mlab-modules/I2CADC01/README.md

# I2CADC01A  - 24-bit ADC converter with I2C interface

The ADC includes a temperature sensor that can be used to compensate cold-junction temperature. Therefore, this module is suitable for use of temperature measurement by thermocouples.

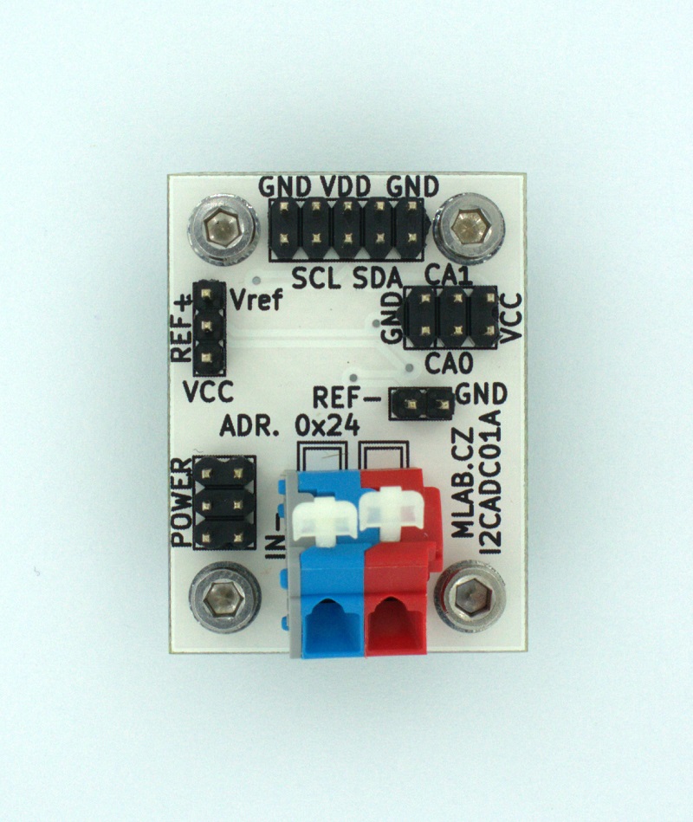
[picture p1: doc/img/I2CADC01A_small.jpg]
LeadImg
