mlab-modules/I2CADC01/doc/gen/README.md

# PCB

Board size: 29.97x40.13 mm (1.18x1.58 inches)

- This is the size of the rectangle that contains the board
- Thickness: 1.6 mm (63 mils)
- Material: FR4
- Finish: HAL
- Layers: 2
- Copper thickness: 35 µm

Solder mask: TOP / BOTTOM

- Color: Green

Silk screen: TOP / BOTTOM

- Color: White

# Important sizes

Clearance: 0.2 mm (8 mils)

Track width: 0.25 mm (10 mils)

- By design rules: 0.25 mm (10 mils)

Drill: 0.75 mm (30 mils)

- Vias: 0.75 mm (30 mils) [Design: 0.6 mm (24 mils)]
- Pads: 1.0 mm (39 mils)
- The above values are real drill sizes, they add 0.1 mm (4 mils) to plated holes (PTH)

Via: 0.89/0.64 mm (35/25 mils)

- By design rules: 0.89/0.51 mm (35/20 mils)
- Micro via: yes [0.51/0.13 mm (20/5 mils)]
- Buried/blind via: yes
- Total: 4 (thru: 4 buried/blind: 0 micro: 0)

Outer Annular Ring: 0.07 mm (3 mils)

- By design rules: 0.26 mm (10 mils)

Eurocircuits class: 10A
- Using min drill 0.75 mm for an OAR of 0.07 mm

# General stats

Components count: (SMD/THT)

- Top: 0/13 (THT)
- Bottom: 19/1 (SMD + THT)

Defined tracks:

- 0.3 mm (12 mils)
- 0.4 mm (16 mils)
- 0.5 mm (20 mils)

Used tracks:

- 0.25 mm (10 mils) (17) defined: no
- 0.3 mm (12 mils) (38) defined: yes
- 0.4 mm (16 mils) (24) defined: yes
- 0.5 mm (20 mils) (64) defined: yes

Defined vias:

Used vias:

- 0.89/0.64 mm (35/25 mils) (Count: 4, Aspect: 1.8 A) defined: no

Holes (excluding vias):

- 0.89 mm (35 mils) (27)
- 1.3 mm (51 mils) (4)
- 3.0 mm (118 mils) (4)

Oval holes:

Drill tools (including vias and computing adjusts and rounding):

- 0.75 mm (30 mils) (4)
- 1.0 mm (39 mils) (27)
- 1.4 mm (55 mils) (4)
- 3.1 mm (122 mils) (4)

Solder paste stats:

Using a paste with 87.75 % alloy, that has an specific gravity for the alloy of 7.4 g/cm³
and 1.0 g/cm³ for the flux. This paste has an specific gravity of  4.15 g/cm³.

The stencil thickness is  0.12 mm.

| Side | Pads with paste | Area [mm²] | Paste [g] |
|---|---|---|---|
| Total  | 53 | 63.30 | 0.32 |

Note: this is just an approximation to the theoretical value. Margins of the solder mask and waste aren't computed.
