mlab-modules/I2CADC01/doc/gen/img/I2CADC01-bottom.png

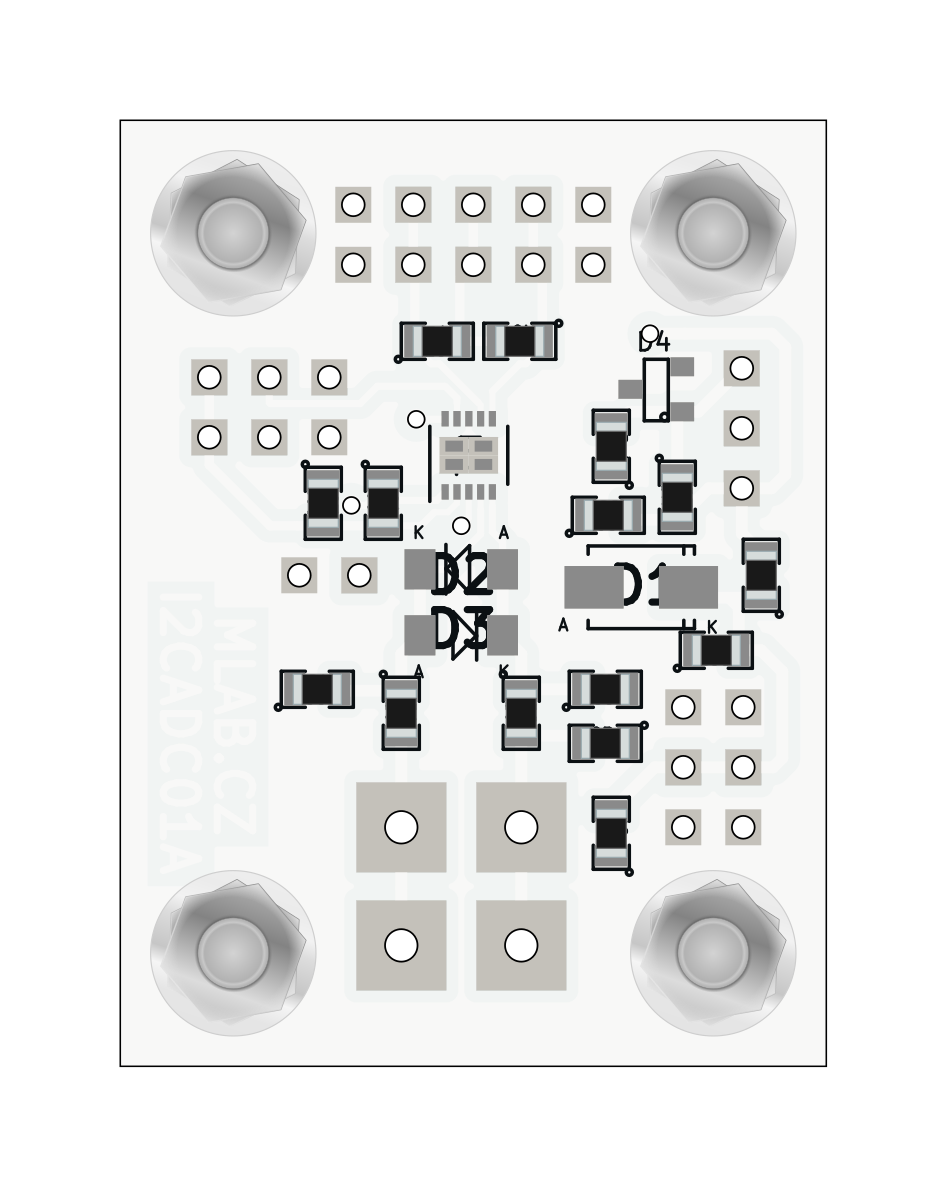
doc/gen/img/I2CADC01-bottom.png
