mlab-modules/I2CADC01/doc/gen/img/I2CADC01-top.png

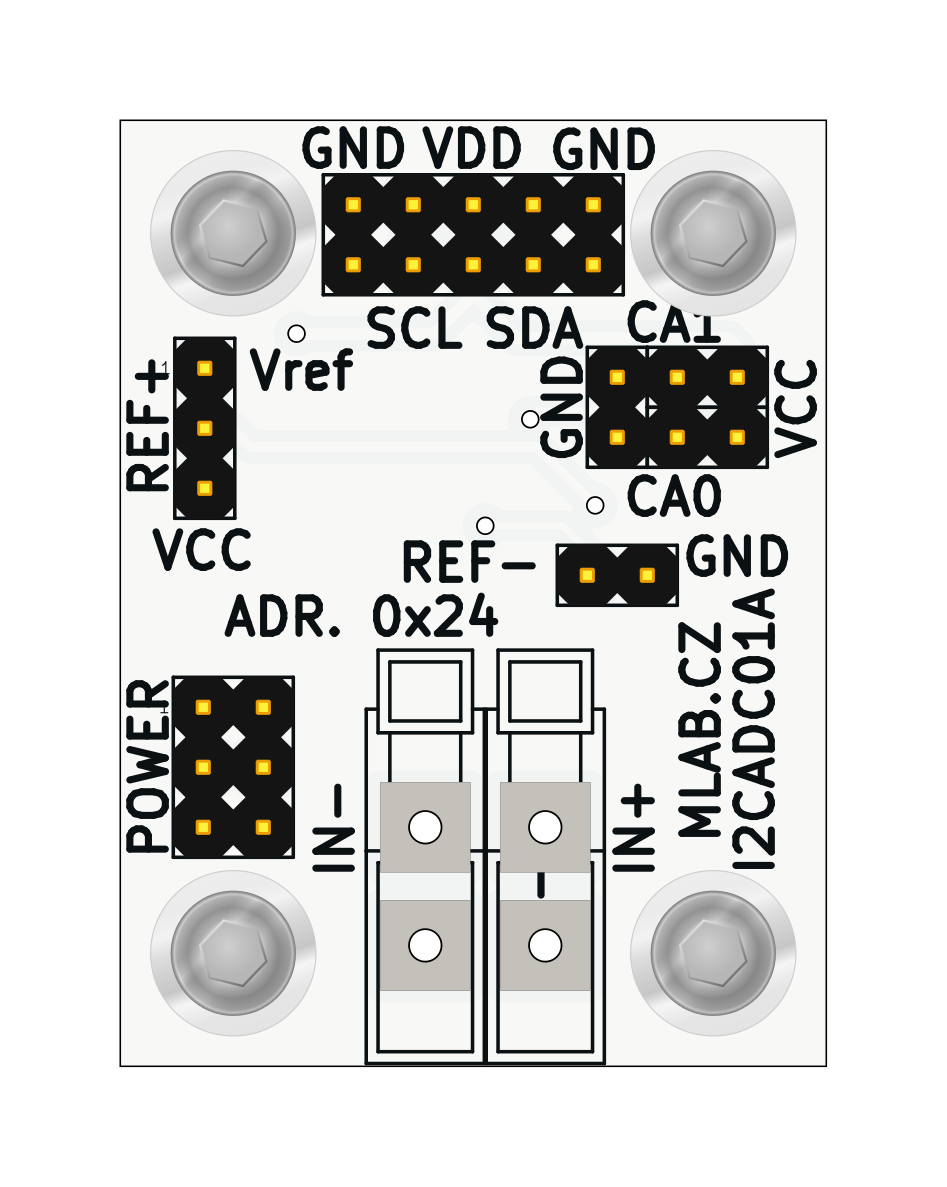
doc/gen/img/I2CADC01-top.png
