mlab-modules/I2CADC01/doc/gen/dxf/I2CADC01-B_Cu.dxf

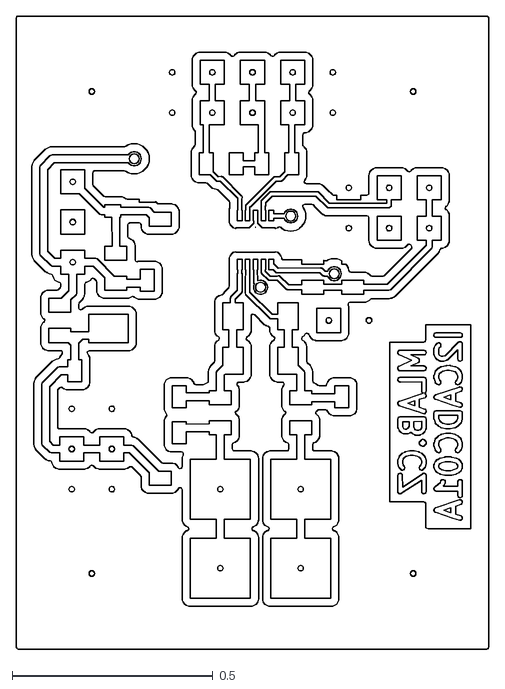
[picture p8: CAD file, 2024-07-16]
doc/gen/dxf/I2CADC01-B_Cu.dxf
1.18 x 1.58
