mlab-modules/I2CADC01/doc/gen/I2CADC01.step

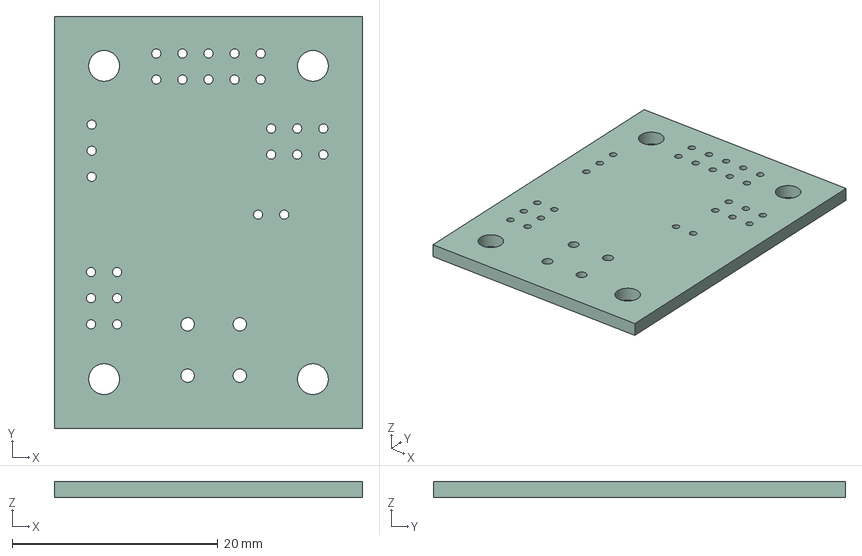
[picture p9: CAD file, 2024-07-16]
doc/gen/I2CADC01.step
30.0 x 40.1 x 1.60 mm
