mlab-modules/I2CADC01/doc/gen/dxf/I2CADC01-B_Courtyard.dxf

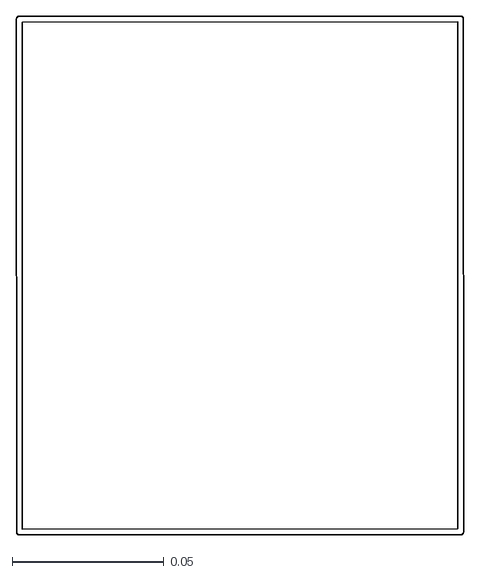
[picture p10: CAD file, 2024-07-16]
doc/gen/dxf/I2CADC01-B_Courtyard.dxf
0.148 x 0.171
