mlab-modules/I2CADC01/doc/gen/dxf/I2CADC01-F_Cu.dxf

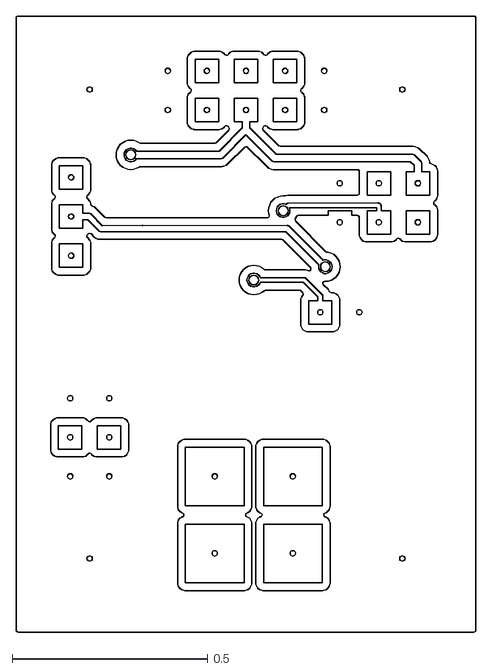
[picture p11: CAD file, 2024-07-16]
doc/gen/dxf/I2CADC01-F_Cu.dxf
1.18 x 1.58
