mlab-modules/I2CADC01/doc/gen/dxf/I2CADC01-B_Fab.dxf

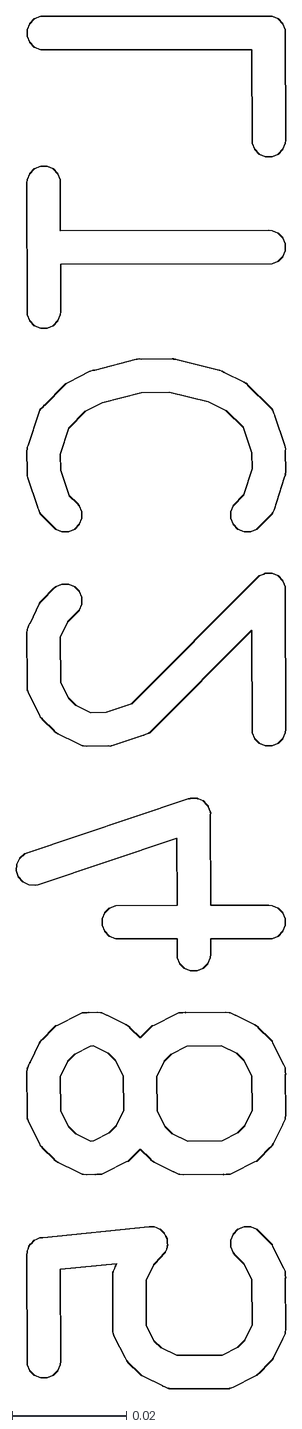
[picture p12: CAD file, 2024-07-16]
doc/gen/dxf/I2CADC01-B_Fab.dxf
0.0471 x 0.24
