mlab-modules/I2CADC01/doc/gen/dxf/I2CADC01-Edge_Cuts.dxf

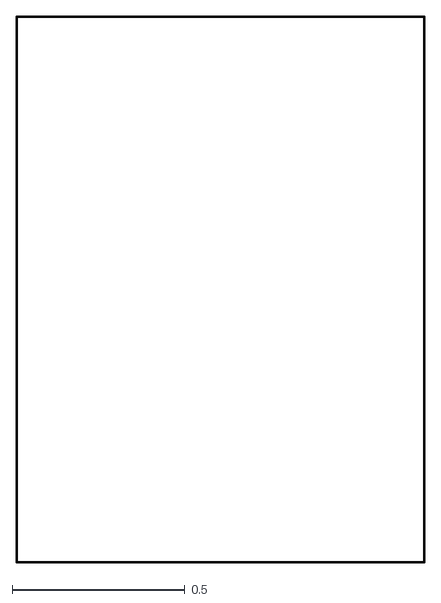
[picture p13: CAD file, 2024-07-16]
doc/gen/dxf/I2CADC01-Edge_Cuts.dxf
1.18 x 1.58
