mlab-modules/I2CADC01/doc/gen/dxf/I2CADC01-User_Comments.dxf

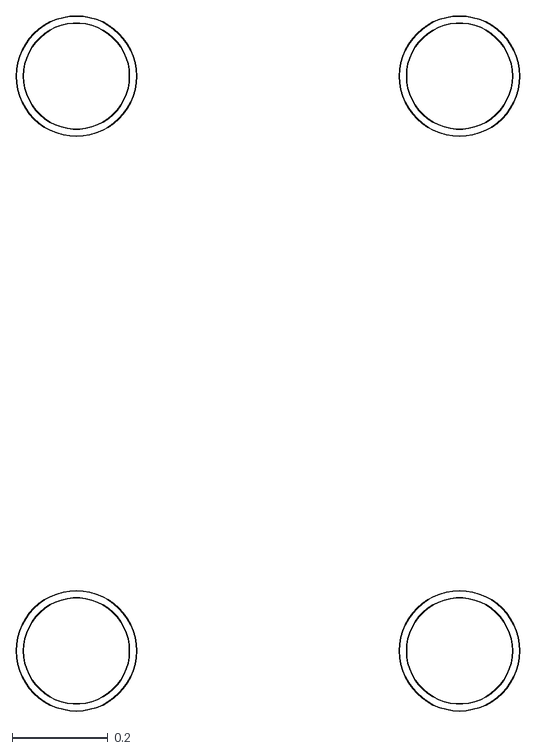
[picture p14: CAD file, 2024-05-31]
doc/gen/dxf/I2CADC01-User_Comments.dxf
1.05 x 1.45
