mlab-modules/I2CADC01/doc/gen/dxf/I2CADC01-B_Adhesive.dxf

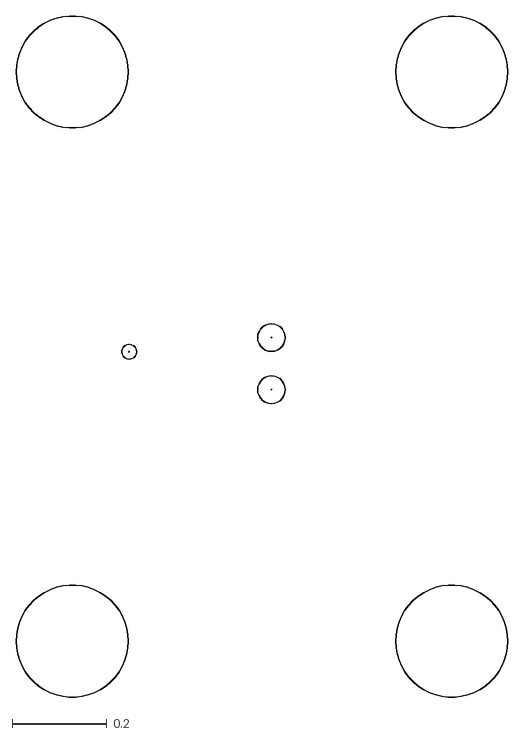
[picture p15: CAD file, 2024-05-31]
doc/gen/dxf/I2CADC01-B_Adhesive.dxf
1.04 x 1.44
