mlab-modules/I2CADC01/doc/gen/dxf/I2CADC01-F_Adhesive.dxf

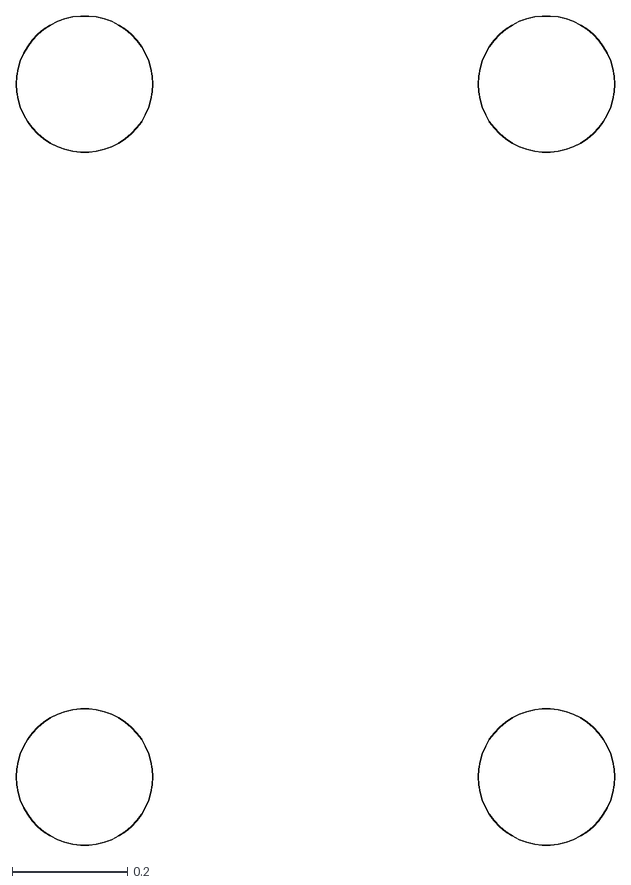
[picture p16: CAD file, 2024-05-31]
doc/gen/dxf/I2CADC01-F_Adhesive.dxf
1.04 x 1.44
