mlab-modules/I2CADC01/(list of files, cad)

Other CAD files:
doc/gen/dxf/I2CADC01-User_Drawings.dxf
doc/gen/dxf/I2CADC01-Margin.dxf
doc/gen/dxf/I2CADC01-F_Courtyard.dxf
doc/gen/dxf/I2CADC01-User_Eco1.dxf
doc/gen/dxf/I2CADC01-F_Fab.dxf
doc/gen/dxf/I2CADC01-User_Eco2.dxf
doc/gen/dxf/I2CADC01-B_Mask.dxf
doc/gen/dxf/I2CADC01-B_Paste.dxf
doc/gen/dxf/I2CADC01-B_Silkscreen.dxf
doc/gen/dxf/I2CADC01-F_Mask.dxf
doc/gen/dxf/I2CADC01-F_Paste.dxf
doc/gen/dxf/I2CADC01-F_Silkscreen.dxf
