mlab-modules/I2CADC01/doc/gen/I2CADC01-schematic.pdf

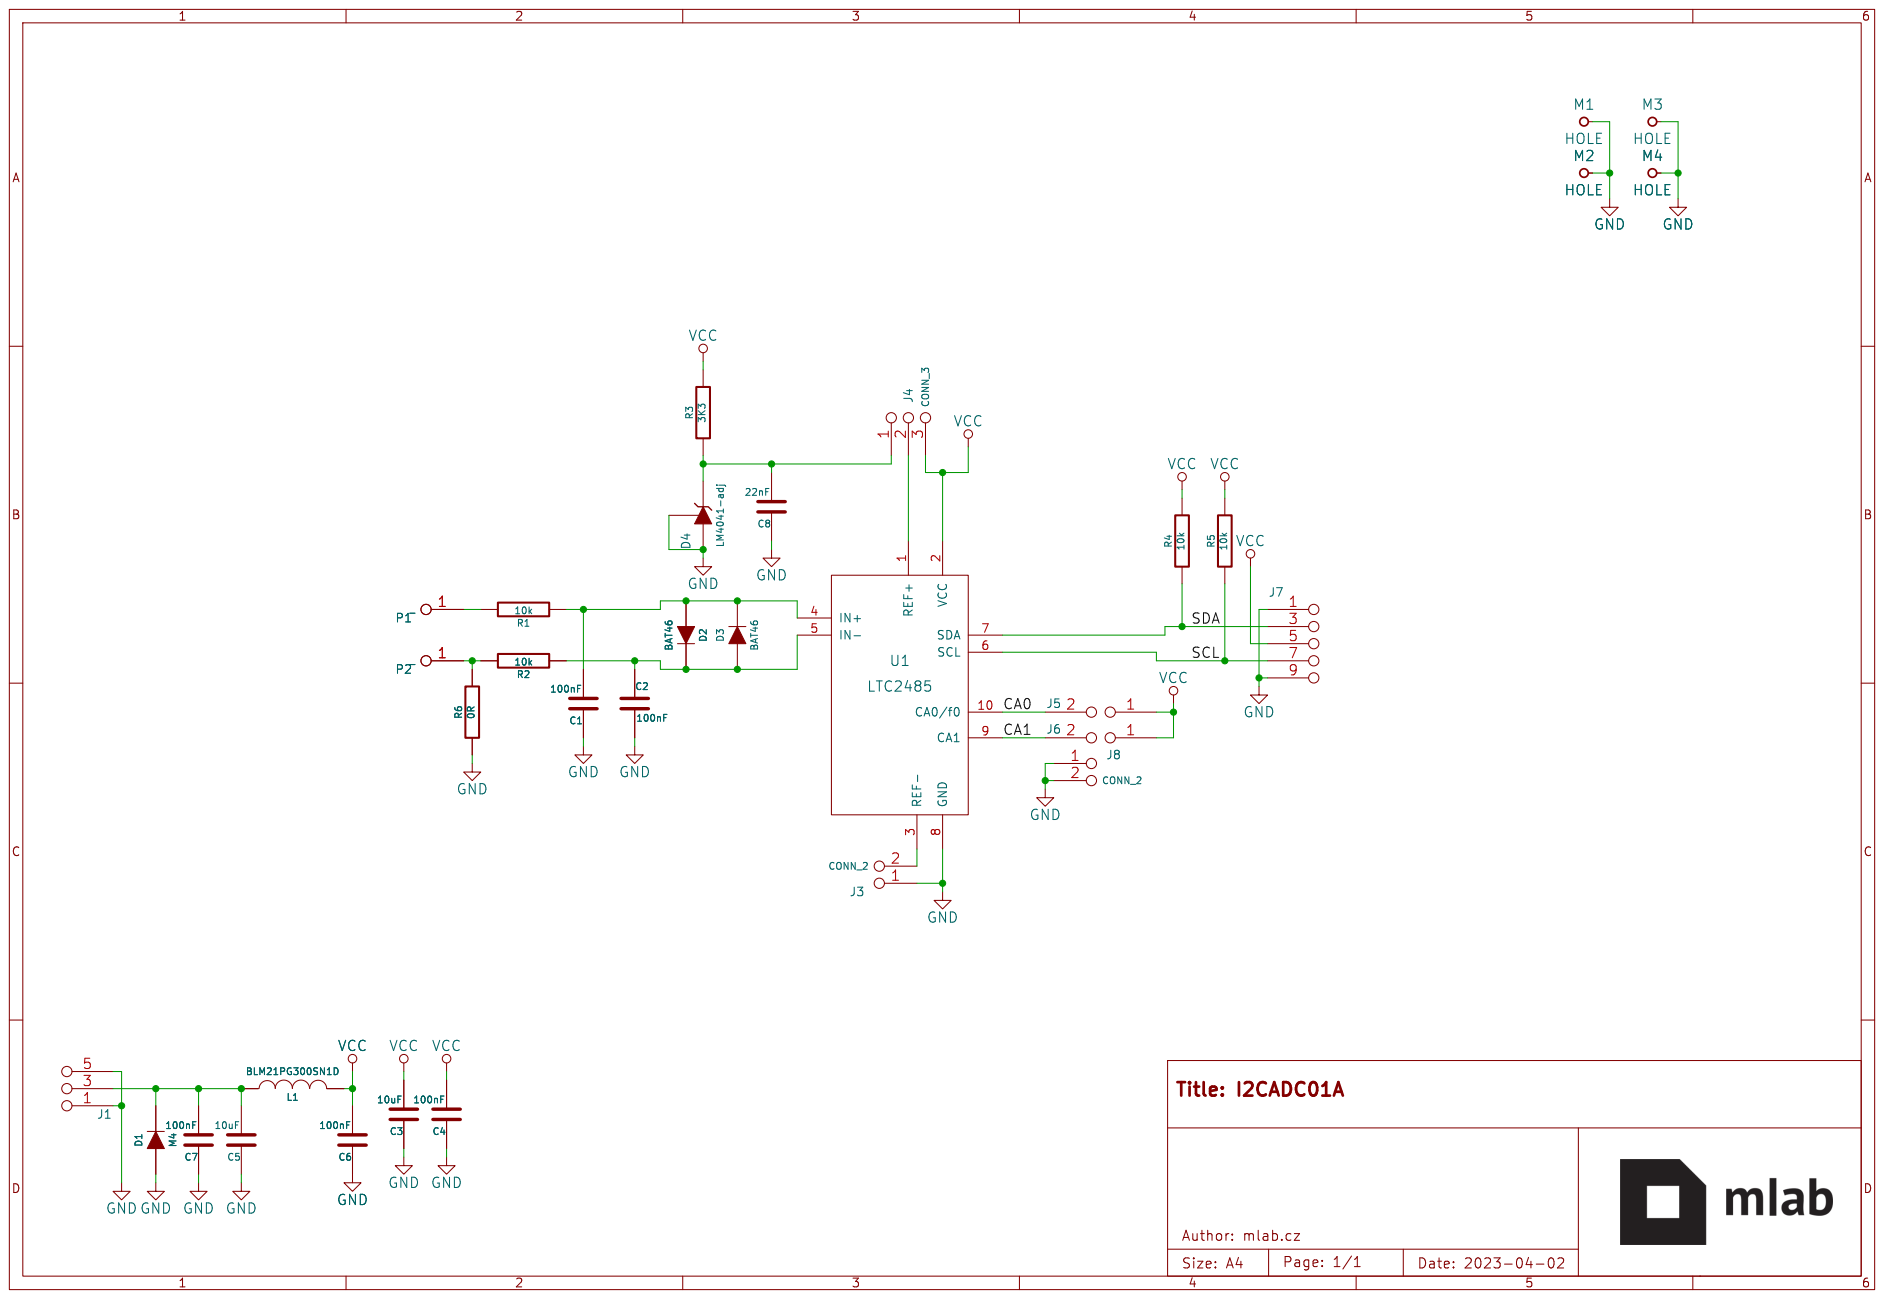
[picture p17: page 1]
