mlab-modules/I2CADC01/hw/cam_profi/assembly/I2CADC01-B_Fab+Edge_Cuts.pdf

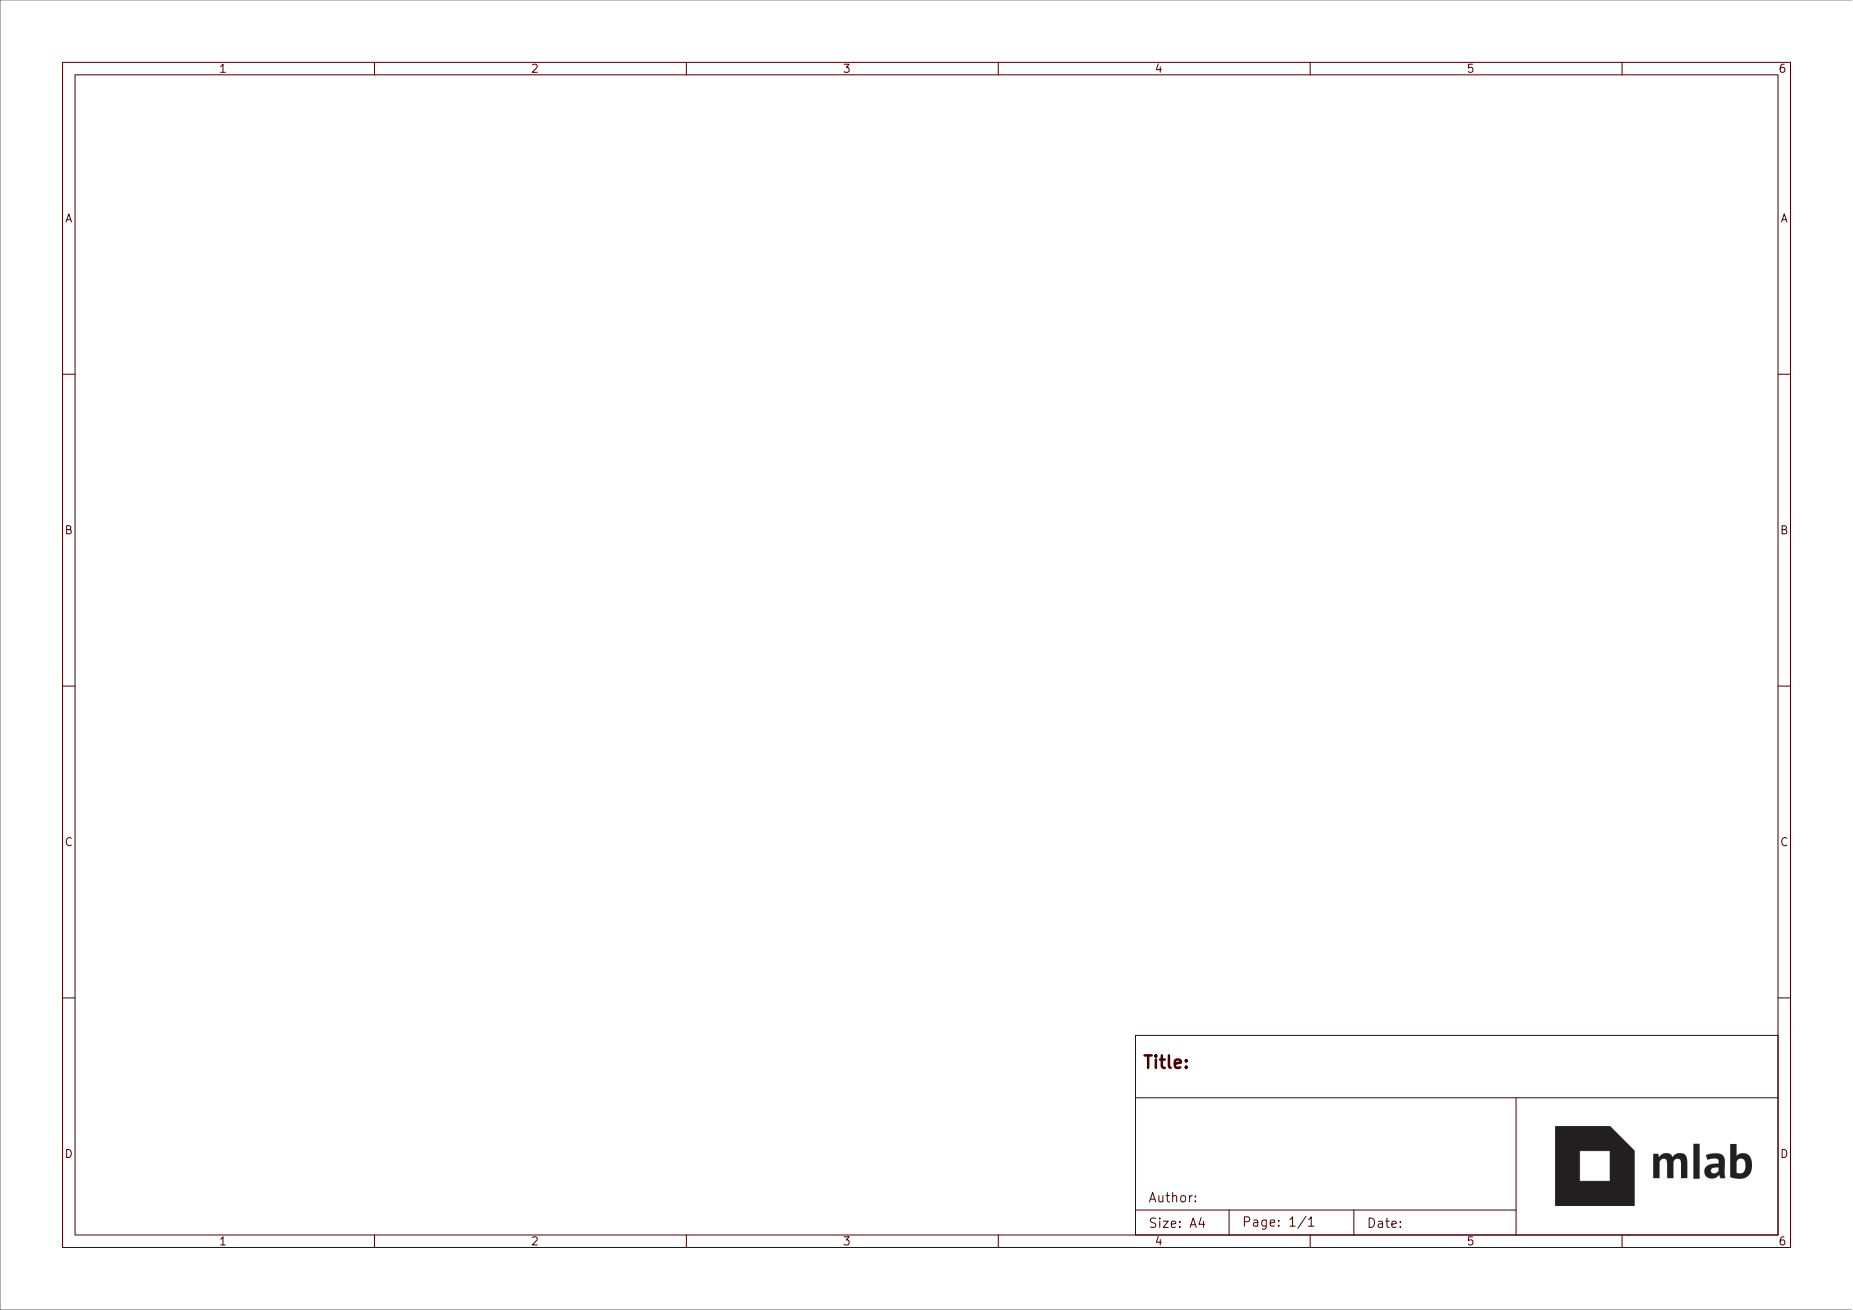
[picture p18: page 1]
