mlab-modules/I2CADC01/hw/sch_pcb/I2CADC01.kicad_pcb

## KiCad design hw/sch_pcb/I2CADC01.kicad_pcb (2023-10-28)

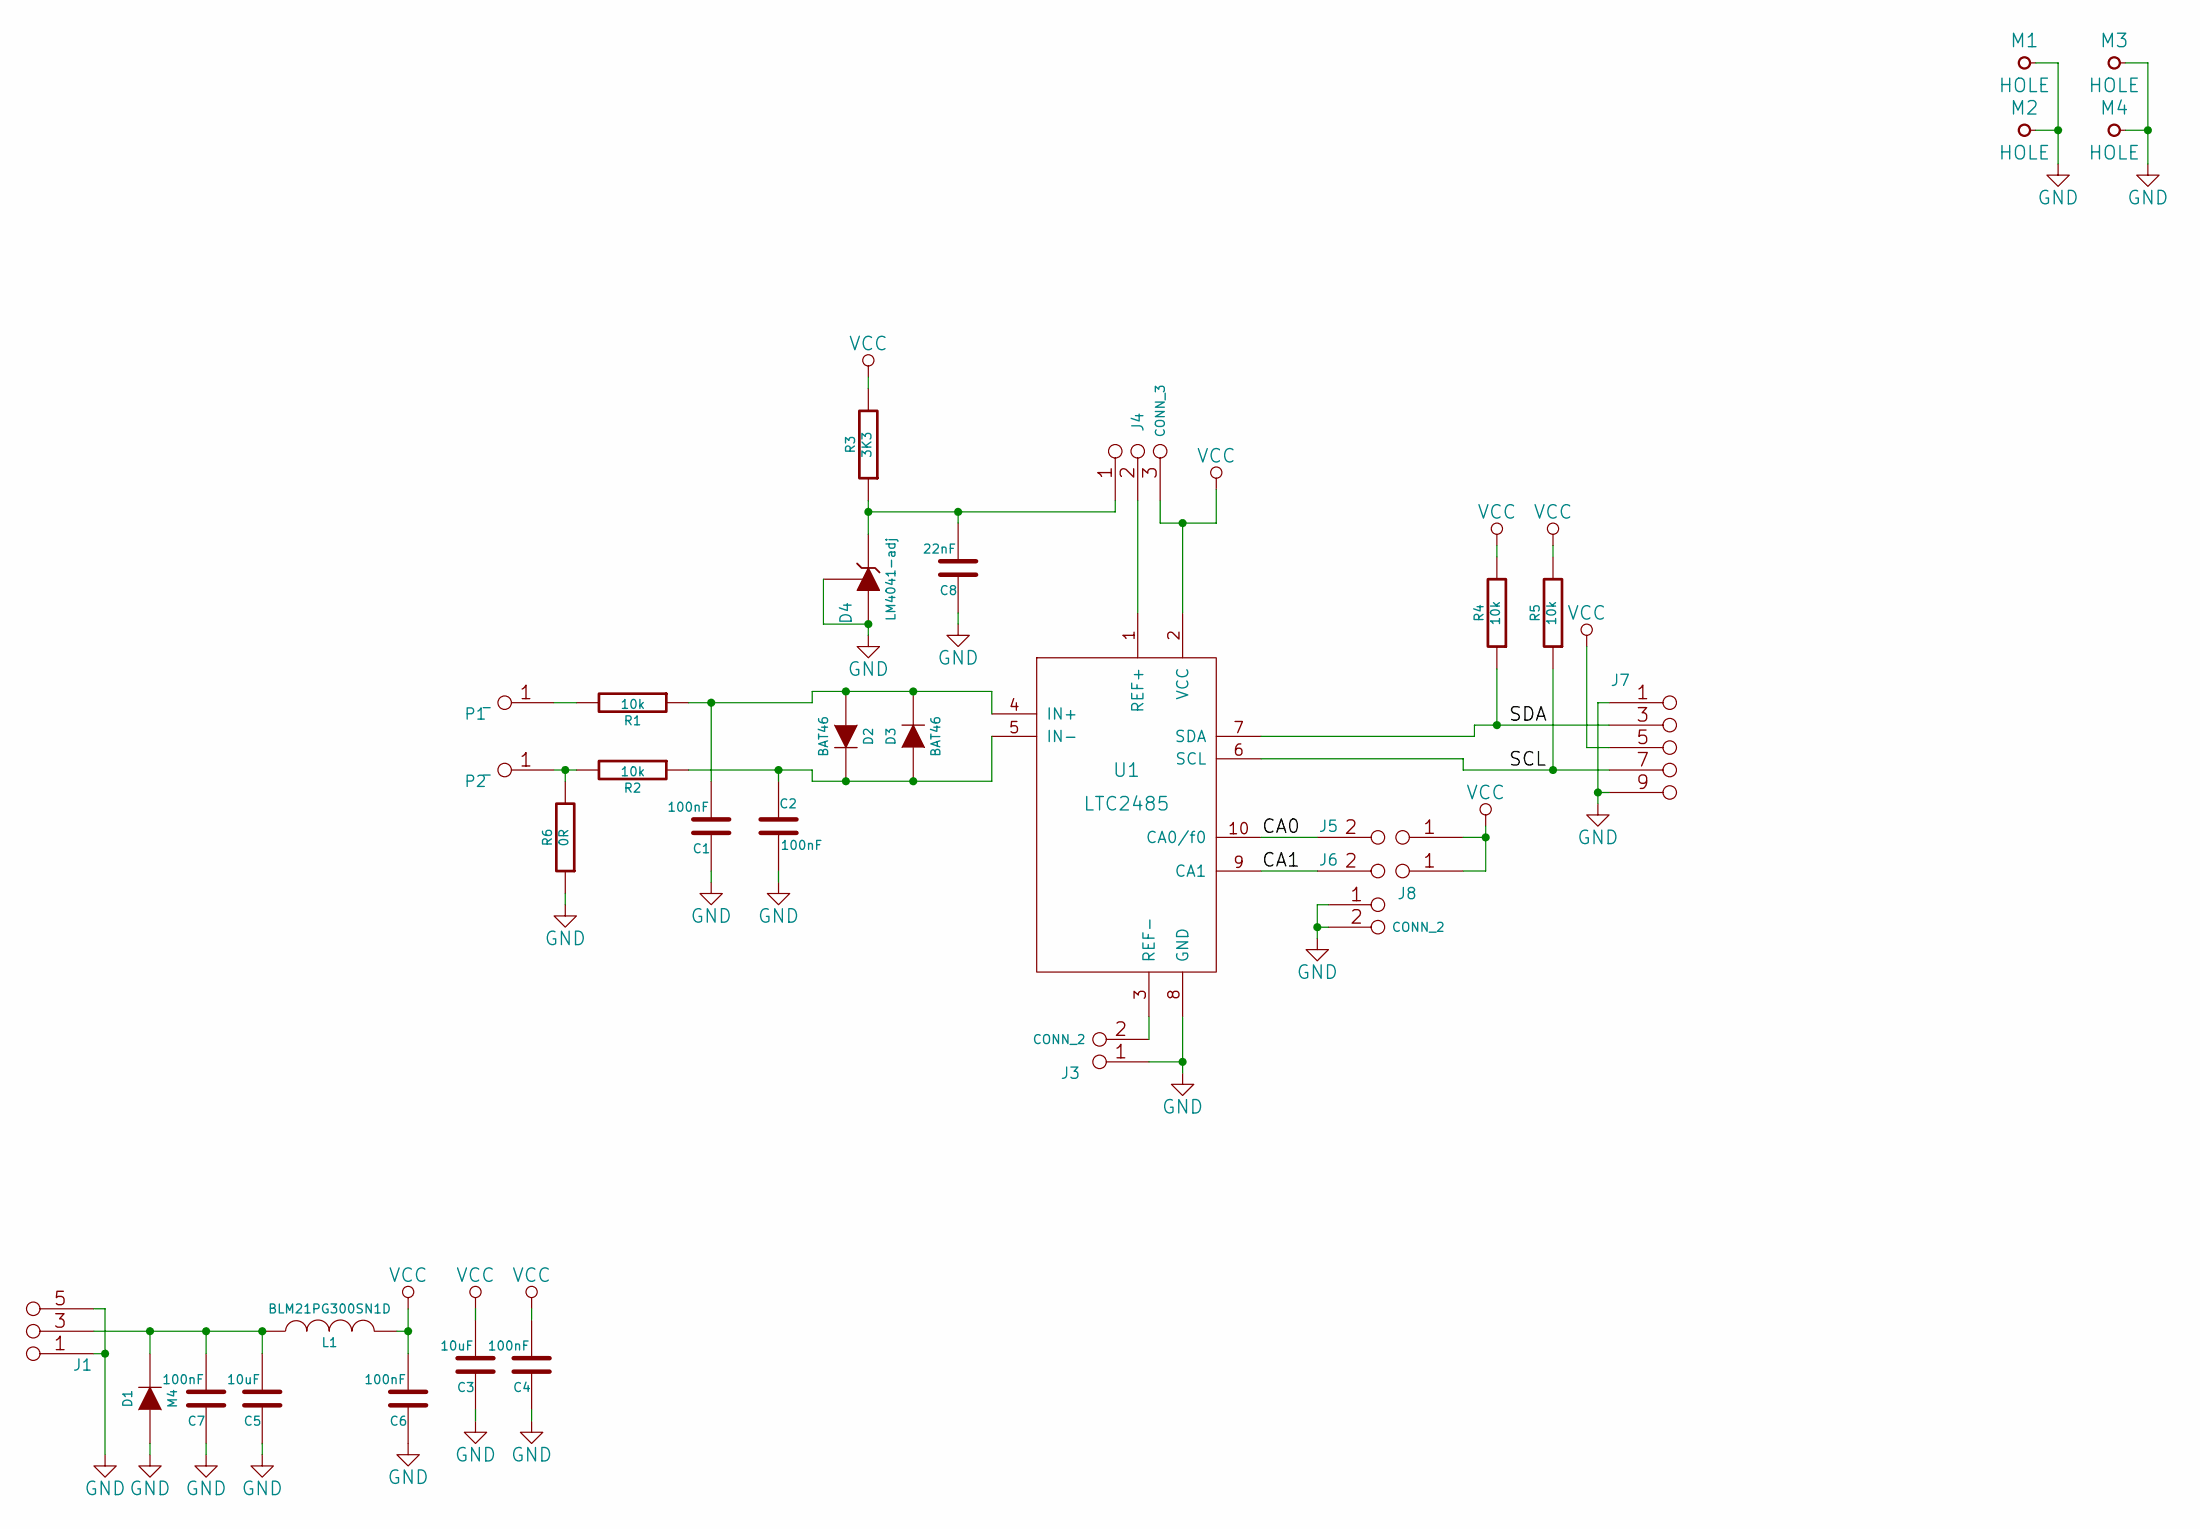
[picture p19: schematic I2CADC01.kicad_sch, I2CADC01A]

Parts:
C1, C2, C4, C6, C7: 100nF; SMD-0805
C3, C5: 10uF; SMD-0805
C8: 22nF; SMD-0805
D1: M4; SMA_Standard
D2, D3: BAT46; MiniMELF_Standard
D4: LM4041-adj; SOT-23
J1: JUMP_3X2; Straight_2x03
J3, J8: CONN_2; Straight_2x01
J4: CONN_3; Straight_1x03
J5, J6: JUMP2_2x1; Straight_2x01
J7: JUMP_5X2; Straight_2x05
L1: BLM21PG300SN1D; SMD-0805
M1, M2, M3, M4: HOLE; MountingHole_3mm
P1, P2: _; WAGO256
R1, R2, R4, R5: 10k; SMD-0805
R3: 3K3; SMD-0805
R6: 0R; SMD-0805
U1: LTC2485; DFN-10-1EP_3x3mm_Pitch0.5mm

Connections:
/CA0: J5.2, U1.10 (CA0/f0)
/CA1: J6.2, U1.9 (CA1)
/SCL: J7.7, J7.8 (7), R5.1, U1.6 (SCL)
/SDA: J7.3 (4), J7.4, R4.1, U1.7 (SDA)
GND: C1.1, C2.2, C3.1, C4.1, C5.1, C6.1, C7.1, C8.1, D1.1 (A), D4.2, D4.3 (A), J1.1 (2), J1.2, J1.5 (6), J1.6, J3.1, J7.1 (2), J7.2, J7.9 (10), J7.10, J8.1, J8.2 (PM), M1.1, M2.1, M3.1, M4.1, R6.1, U1.8 (GND), U1.11 (GND)
unnamed: C1.2, D2.1 (A), D3.2 (K), R1.1, U1.4 (IN+)
unnamed: C2.1, D2.2 (K), D3.1 (A), R2.1, U1.5 (IN-)
unnamed: C5.2, C7.2, D1.2 (K), J1.3 (4), J1.4, L1.1
unnamed: C8.2, D4.1 (K), J4.1, R3.1
unnamed: J3.2 (PM), U1.3 (REF-)
unnamed: J4.2 (PM), U1.1 (REF+)
unnamed: P1.1, R1.2
unnamed: P2.1, R2.2, R6.2
VCC: C3.2, C4.2, C6.2, J4.3, J5.1, J6.1, J7.5 (6), J7.6, L1.2, R3.2, R4.2, R5.2, U1.2 (VCC)

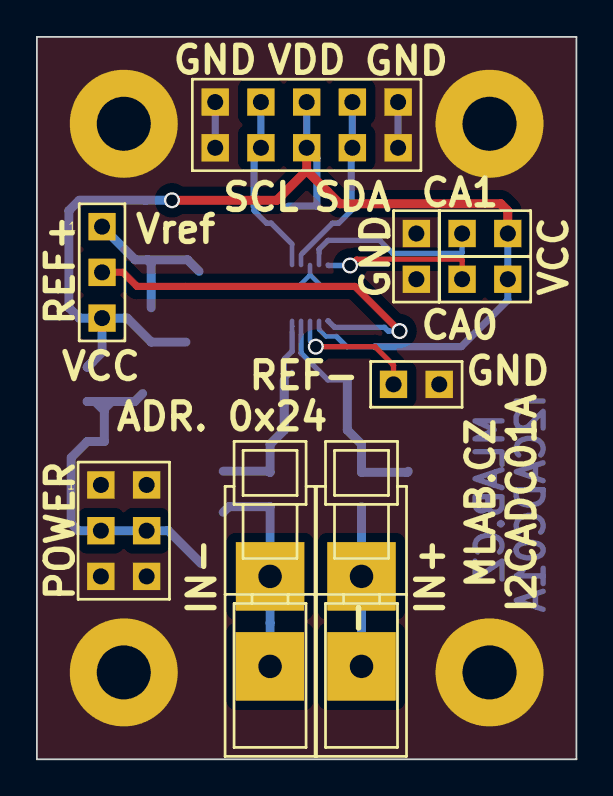
[picture p20: board I2CADC01.kicad_pcb from above]

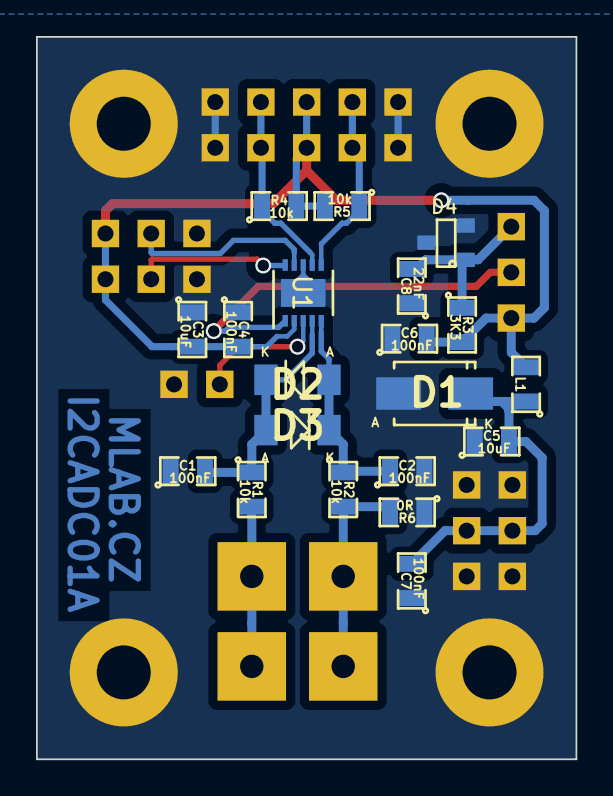
[picture p21: board I2CADC01.kicad_pcb from below]

Board: 2 copper layers, 30.0 x 40.1 mm, 33 parts (20 on the bottom side), 14 nets.
