mlab-modules/I2CADC01/(commit log)

2017-08-24 Renaming top directories.
    [I2CADC01A.kicad_pcb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]
2018-04-11 [MLABweb] Documentaion edits; I2CADC01A
2019-08-17 Improve project descriptions for ADC modules
2023-04-02 Upgrade project to KiCAD v6.
    [I2CADC01.kicad_pcb, I2CADC01.kicad_sch, I2CADC01A.sch]
2023-04-02 Adding assets update title block.
    [I2CADC01.kicad_pcb, I2CADC01.kicad_sch]
2023-04-02 Update actions products
    [I2CADC01-B_Adhesive.dxf, I2CADC01-B_Courtyard.dxf, I2CADC01-B_Cu.dxf, I2CADC01-B_Fab.dxf, I2CADC01-B_Mask.dxf, I2CADC01-B_Paste.dxf, I2CADC01-B_Silkscreen.dxf, I2CADC01-Edge_Cuts.dxf]
2023-10-28 Update project files. cleanup repository.
    [I2CADC01.kicad_pcb, I2CADC01.kicad_sch]
